Patronics/USBC-Tester/USBCTester/USBCTester.kicad_pcb

## KiCad design USBCTester/USBCTester.kicad_pcb (2024-05-14)

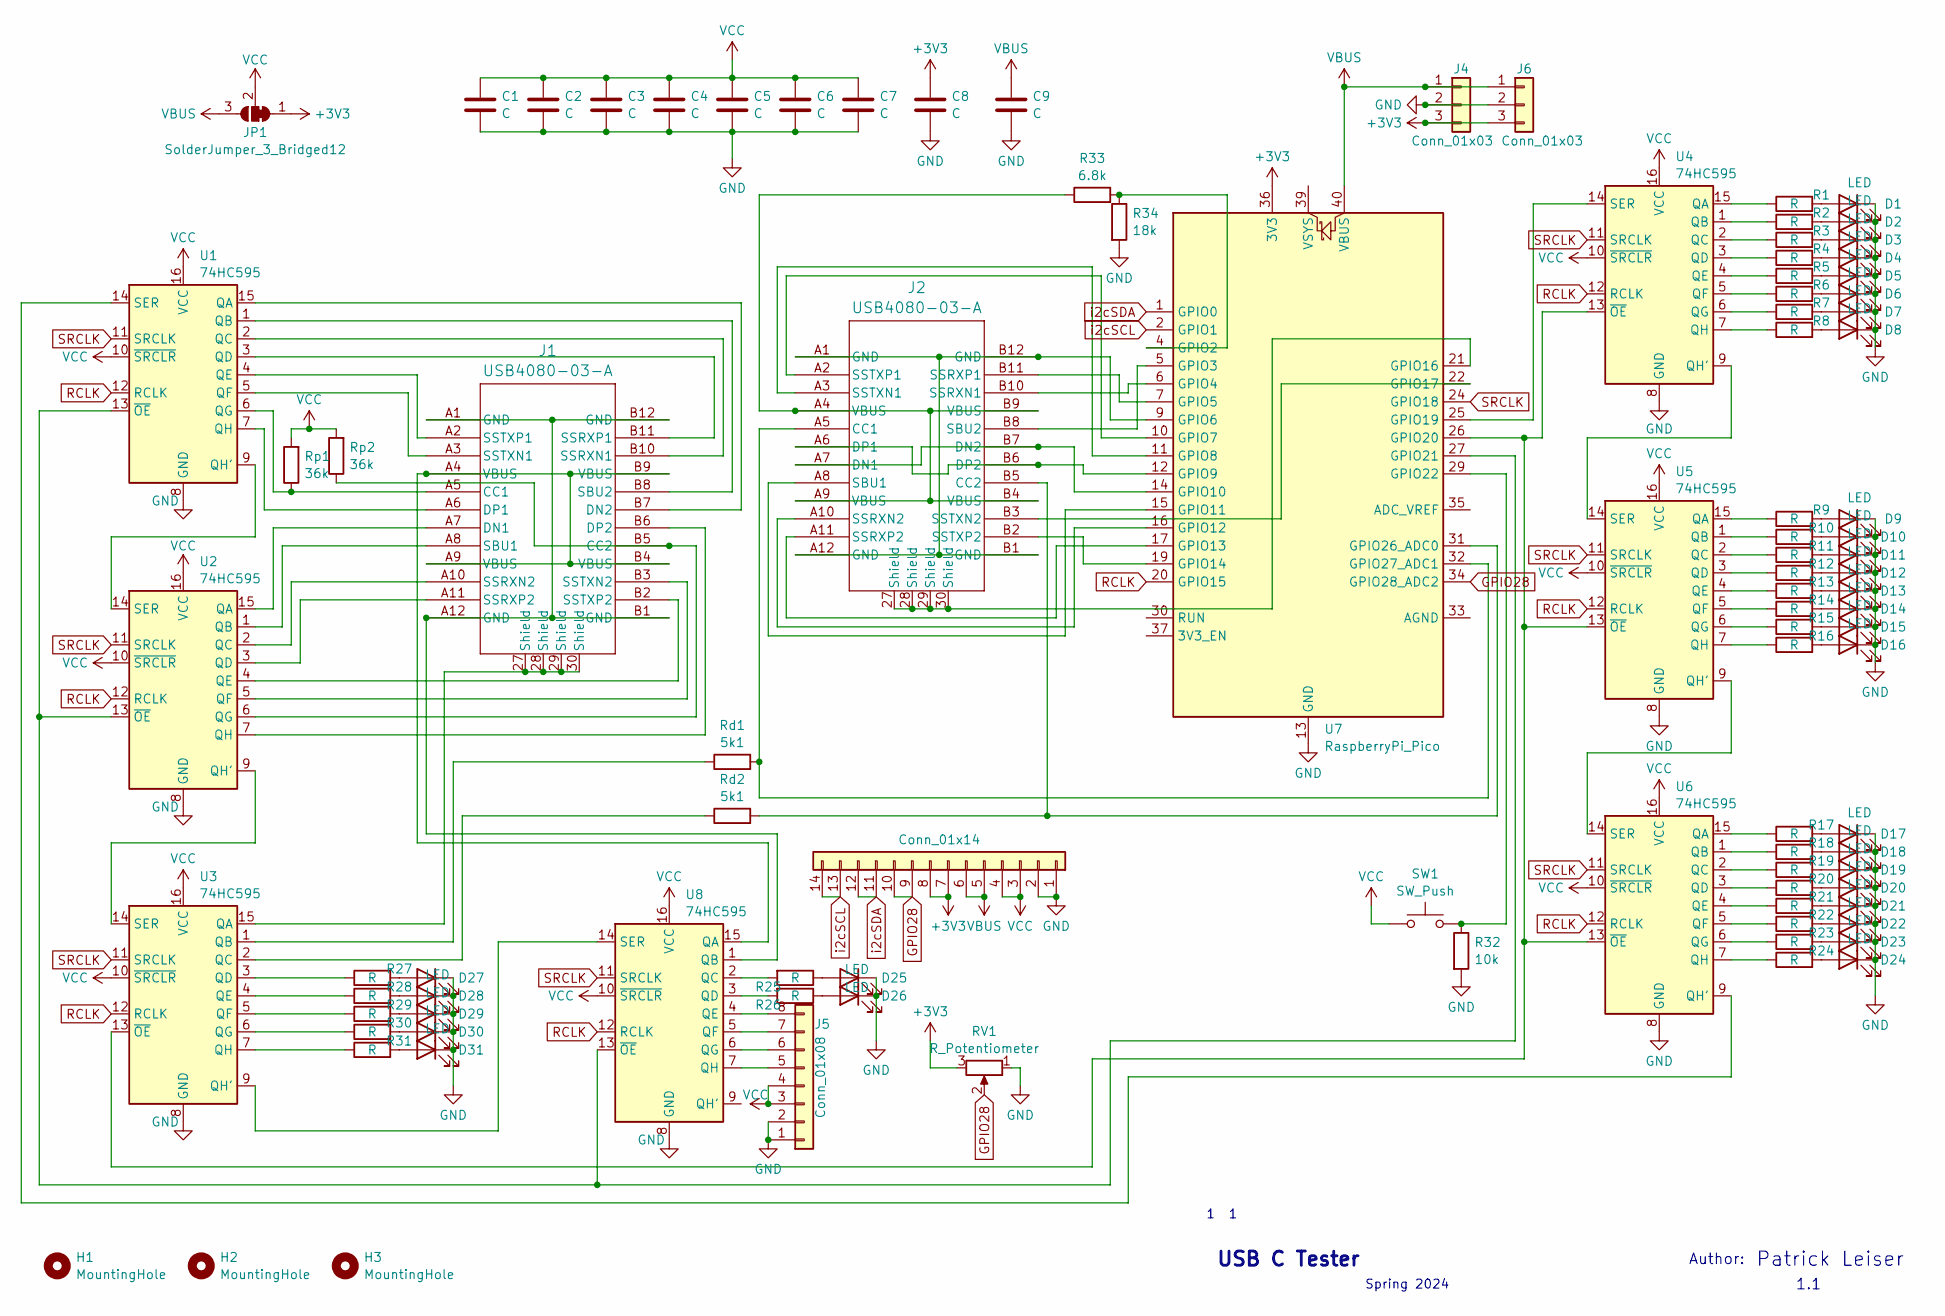
[picture p2: schematic USBCTester.kicad_sch]

Parts:
C1, C2, C3, C4, C5, C6, C7, C8, C9: C; C_0603_1608Metric
D1, D2, D3, D4, D5, D6, D7, D8, D9, D10, D11, D12, D13, D14, D15, D16, D17, D18, D19, D20, D21, D22, D23, D24, D25, D26, D27, D28, D29, D30, D31: LED; LED_0603_1608Metric
H1, H2, H3: MountingHole; MountingHole_3.2mm_M3
J1, J2: USB4080-03-A; USB4080-03-A_GCT_RoundHoles
J3: Conn_01x14; PinSocket_1x14_P2.54mm_Vertical
J4, J6: Conn_01x03; PinSocket_1x03_P2.54mm_Vertical
J5: Conn_01x08; PinHeader_2x04_P2.54mm_Vertical
JP1: SolderJumper_3_Bridged12; SolderJumper-3_P1.3mm_Bridged12_RoundedPad1.0x1.5mm
R1, R2, R3, R4, R5, R6, R7, R8, R9, R10, R11, R12, R13, R14, R15, R16, R17, R18, R19, R20, R21, R22, R23, R24, R25, R26, R27, R28, R29, R30, R31: R; R_0603_1608Metric
R32: 10k; R_0603_1608Metric
R33: 6.8k; R_0603_1608Metric
R34: 18k; R_0603_1608Metric
RV1: R_Potentiometer; TRIM_35WR10KLFTR
Rd1, Rd2: 5k1; R_0603_1608Metric
Rp1, Rp2: 36k; R_0603_1608Metric
SW1: SW_Push; SW_Push_1P1T_NO_6x6mm_H9.5mm
U1, U2, U3, U4, U5, U6, U8: 74HC595; SOIC-16_3.9x9.9mm_P1.27mm
U7: RaspberryPi_Pico; RaspberryPi_Pico_Common

Connections:
+3V3: C8.1, J3.7, J3.8, J4.3, J6.3, JP1.1 (A), RV1.3, U7.36 (3V3)
GND: C1.2, C2.2, C3.2, C4.2, C5.2, C6.2, C7.2, C8.2, C9.2, D1.1 (K), D2.1 (K), D3.1 (K), D4.1 (K), D5.1 (K), D6.1 (K), D7.1 (K), D8.1 (K), D9.1 (K), D10.1 (K), D11.1 (K), D12.1 (K), D13.1 (K), D14.1 (K), D15.1 (K), D16.1 (K), D17.1 (K), D18.1 (K), D19.1 (K), D20.1 (K), D21.1 (K), D22.1 (K), D23.1 (K), D24.1 (K), D25.1 (K), D26.1 (K), D27.1 (K), D28.1 (K), D29.1 (K), D30.1 (K), D31.1 (K), J3.1, J3.2, J4.2, J5.1, J5.2, J6.2, R32.2, R34.2, RV1.1, U1.8 (GND), U2.8 (GND), U3.8 (GND), U4.8 (GND), U5.8 (GND), U6.8 (GND), U7.3 (GND), U7.8 (GND), U7.13 (GND), U7.18 (GND), U7.23 (GND), U7.28 (GND), U7.38 (GND), U8.8 (GND)
GPIO28: J3.9, J3.10, RV1.2, U7.34 (GPIO28_ADC2)
unnamed: D1.2 (A), R1.2
unnamed: D2.2 (A), R2.2
unnamed: D3.2 (A), R3.2
unnamed: D4.2 (A), R4.2
unnamed: D5.2 (A), R5.2
unnamed: D6.2 (A), R6.2
unnamed: D7.2 (A), R7.2
unnamed: D8.2 (A), R8.2
unnamed: D9.2 (A), R9.2
unnamed: D10.2 (A), R10.2
unnamed: D11.2 (A), R11.2
unnamed: D12.2 (A), R12.2
unnamed: D13.2 (A), R13.2
unnamed: D14.2 (A), R14.2
unnamed: D15.2 (A), R15.2
unnamed: D16.2 (A), R16.2
unnamed: D17.2 (A), R17.2
unnamed: D18.2 (A), R18.2
unnamed: D19.2 (A), R19.2
unnamed: D20.2 (A), R20.2
unnamed: D21.2 (A), R21.2
unnamed: D22.2 (A), R22.2
unnamed: D23.2 (A), R23.2
unnamed: D24.2 (A), R24.2
unnamed: D25.2 (A), R25.1
unnamed: D26.2 (A), R26.1
unnamed: D27.2 (A), R27.2
unnamed: D28.2 (A), R28.2
unnamed: D29.2 (A), R29.2
unnamed: D30.2 (A), R30.2
unnamed: D31.2 (A), R31.2
unnamed: J1.A5 (CC1), Rp1.1, U1.6 (QG)
unnamed: J1.B5 (CC2), Rp2.1, U2.6 (QG)
unnamed: J1.A7 (DN1), U2.15 (QA)
unnamed: J1.B7 (DN2), U1.15 (QA)
unnamed: J1.A6 (DP1), U1.7 (QH)
unnamed: J1.B6 (DP2), U2.7 (QH)
unnamed: J1.A8 (SBU1), U2.1 (QB)
unnamed: J1.B8 (SBU2), U1.1 (QB)
unnamed: J1.B10 (SSRXN1), U1.2 (QC)
unnamed: J1.A10 (SSRXN2), U2.2 (QC)
unnamed: J1.B11 (SSRXP1), U1.3 (QD)
unnamed: J1.A11 (SSRXP2), U2.3 (QD)
unnamed: J1.A3 (SSTXN1), U1.5 (QF)
unnamed: J1.B3 (SSTXN2), U2.5 (QF)
unnamed: J1.A2 (SSTXP1), U1.4 (QE)
unnamed: J1.B2 (SSTXP2), U2.4 (QE)
unnamed: J2.A5 (CC1), Rd1.2, U7.32 (GPIO27_ADC1)
unnamed: J2.B5 (CC2), Rd2.2, U7.31 (GPIO26_ADC0)
unnamed: J2.A7 (DN1), J2.B7 (DN2), U7.14 (GPIO10)
unnamed: J2.A6 (DP1), J2.B6 (DP2), U7.12 (GPIO9)
unnamed: J2.A8 (SBU1), U7.15 (GPIO11)
unnamed: J2.B8 (SBU2), U7.5 (GPIO3)
unnamed: J2.B10 (SSRXN1), U7.6 (GPIO4)
unnamed: J2.A10 (SSRXN2), U7.16 (GPIO12)
unnamed: J2.B11 (SSRXP1), U7.7 (GPIO5)
unnamed: J2.A11 (SSRXP2), U7.17 (GPIO13)
unnamed: J2.A3 (SSTXN1), U7.11 (GPIO8)
unnamed: J2.B3 (SSTXN2), U7.22 (GPIO17)
unnamed: J2.A2 (SSTXP1), U7.10 (GPIO7)
unnamed: J2.B2 (SSTXP2), U7.19 (GPIO14)
unnamed: J2.A4 (VBUS), J2.A9 (VBUS), J2.B4 (VBUS), J2.B9 (VBUS), R33.1
unnamed: J5.5, U8.7 (QH)
unnamed: J5.6, U8.6 (QG)
unnamed: J5.7, U8.5 (QF)
unnamed: J5.8, U8.4 (QE)
unnamed: U1.9 (QH'), U2.14 (SER)
unnamed: U1.14 (SER), U6.9 (QH')
unnamed: U1.13 (~OE), U2.13 (~OE), U7.27 (GPIO21), U8.13 (~OE)
unnamed: U2.9 (QH'), U3.14 (SER)
unnamed: J1.27 (Shield), J1.28 (Shield), J1.29 (Shield), J1.30 (Shield), U3.15 (QA)
unnamed: Rd1.1, U3.1 (QB)
unnamed: Rd2.1, U3.2 (QC)
unnamed: R27.1, U3.3 (QD)
unnamed: R28.1, U3.4 (QE)
unnamed: R29.1, U3.5 (QF)
unnamed: R30.1, U3.6 (QG)
unnamed: U3.9 (QH'), U8.14 (SER)
unnamed: R31.1, U3.7 (QH)
unnamed: U3.13 (~OE), U4.13 (~OE), U5.13 (~OE), U6.13 (~OE), U7.26 (GPIO20)
unnamed: R1.1, U4.15 (QA)
unnamed: R2.1, U4.1 (QB)
unnamed: R3.1, U4.2 (QC)
unnamed: R4.1, U4.3 (QD)
unnamed: R5.1, U4.4 (QE)
unnamed: R6.1, U4.5 (QF)
unnamed: R7.1, U4.6 (QG)
unnamed: U4.9 (QH'), U5.14 (SER)
unnamed: R8.1, U4.7 (QH)
unnamed: U4.14 (SER), U7.25 (GPIO19)
unnamed: R9.1, U5.15 (QA)
unnamed: R10.1, U5.1 (QB)
unnamed: R11.1, U5.2 (QC)
unnamed: R12.1, U5.3 (QD)
unnamed: R13.1, U5.4 (QE)
unnamed: R14.1, U5.5 (QF)
unnamed: R15.1, U5.6 (QG)
unnamed: U5.9 (QH'), U6.14 (SER)
unnamed: R16.1, U5.7 (QH)
unnamed: R17.1, U6.15 (QA)
unnamed: R18.1, U6.1 (QB)
unnamed: R19.1, U6.2 (QC)
unnamed: R20.1, U6.3 (QD)
unnamed: R21.1, U6.4 (QE)
unnamed: R22.1, U6.5 (QF)
unnamed: R23.1, U6.6 (QG)
unnamed: R24.1, U6.7 (QH)
unnamed: R33.2, R34.1, U7.4 (GPIO2)
unnamed: J2.A1 (GND), J2.A12 (GND), J2.B1 (GND), J2.B12 (GND), U7.9 (GPIO6)
unnamed: J2.27 (Shield), J2.28 (Shield), J2.29 (Shield), J2.30 (Shield), U7.21 (GPIO16)
unnamed: R32.1, SW1.2, U7.29 (GPIO22)
unnamed: J1.A4 (VBUS), J1.A9 (VBUS), J1.B4 (VBUS), J1.B9 (VBUS), U8.15 (QA)
unnamed: J1.A1 (GND), J1.A12 (GND), J1.B1 (GND), J1.B12 (GND), U8.1 (QB)
unnamed: R25.2, U8.2 (QC)
unnamed: R26.2, U8.3 (QD)
RCLK: U1.12 (RCLK), U2.12 (RCLK), U3.12 (RCLK), U4.12 (RCLK), U5.12 (RCLK), U6.12 (RCLK), U7.20 (GPIO15), U8.12 (RCLK)
SRCLK: U1.11 (SRCLK), U2.11 (SRCLK), U3.11 (SRCLK), U4.11 (SRCLK), U5.11 (SRCLK), U6.11 (SRCLK), U7.24 (GPIO18), U8.11 (SRCLK)
VBUS: C9.1, J3.5, J3.6, J4.1, J6.1, JP1.3 (B), U7.40 (VBUS)
VCC: C1.1, C2.1, C3.1, C4.1, C5.1, C6.1, C7.1, J3.3, J3.4, J5.3, J5.4, JP1.2 (C), Rp1.2, Rp2.2, SW1.1, U1.10 (~SRCLR), U1.16 (VCC), U2.10 (~SRCLR), U2.16 (VCC), U3.10 (~SRCLR), U3.16 (VCC), U4.10 (~SRCLR), U4.16 (VCC), U5.10 (~SRCLR), U5.16 (VCC), U6.10 (~SRCLR), U6.16 (VCC), U8.10 (~SRCLR), U8.16 (VCC)
i2cSCL: J3.13, J3.14, U7.2 (GPIO1)
i2cSDA: J3.11, J3.12, U7.1 (GPIO0)

Notes on the sheet:
Author:
Spring 2024
Patrick Leiser
1.1
1 1
USB C Tester

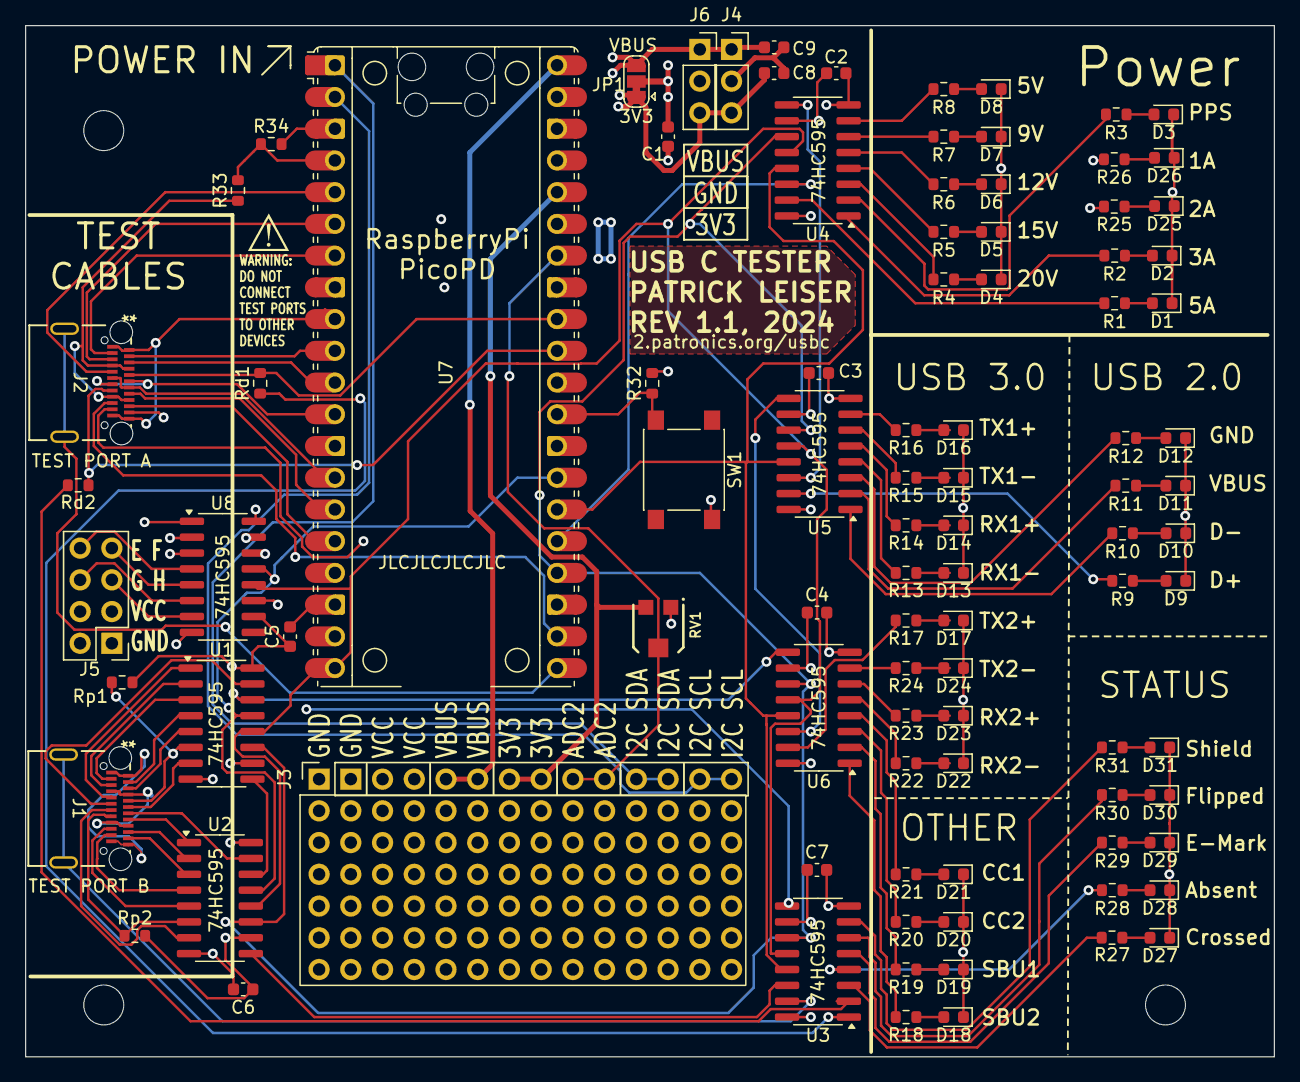
[picture p3: board USBCTester.kicad_pcb from above]

Board: 4 copper layers, 100.0 x 82.6 mm, 99 parts (0 on the bottom side), 124 nets.

Other parts of the board:
PB1: ProtoBoard 14x6
