Patronics/USBC-Tester/(commit log)

2024-02-11 initial commit, add kicad files so far
    [USBCTester.kicad_pcb, USBCTester.kicad_sch]
2024-02-11 add power plane and vias for high current and decoupling caps
    [USBCTester.kicad_pcb, USBCTester.kicad_sch]
2024-02-12 continu wiring and add decoupling caps
    [USBCTester.kicad_pcb, USBCTester.kicad_sch]
2024-02-12 add usb c port footprint and symbol
2024-02-12 organize usb2 and usb3 status leds
    [USBCTester.kicad_pcb]
2024-02-13 add more leds and route almost everything
    [USBCTester.kicad_pcb, USBCTester.kicad_sch]
2024-02-13 label all LEDs
    [USBCTester.kicad_pcb]
2024-02-13 add breakout pins for prototyping
    [USBCTester.kicad_pcb, USBCTester.kicad_sch]
2024-02-16 made board more compact
    [USBCTester.kicad_pcb]
2024-02-16 add 3rd incompatible footprint design
    [USBCTester.kicad_pcb, USBCTester.kicad_sch]
2024-02-16 switch to USB4080 footprint
    [USBCTester.kicad_pcb, USBCTester.kicad_sch]
2024-02-16 add protoboard, lots of tweaks and silkscreen improvements
    [USBCTester.kicad_pcb, USBCTester.kicad_sch]
2024-02-21 many tweaks to finalize design, then Schematic update for safety with external devices
    [USBCTester.kicad_pcb, USBCTester.kicad_sch]
2024-02-21 update layout with improved external device safety and testing for active cables
    [USBCTester.kicad_pcb, USBCTester.kicad_sch]
2024-02-26 pretty and useful back silkscreen
    [USBCTester.kicad_pcb]
2024-02-27 adjust layout to preseve i2c pins, and general layout cleanup
    [USBCTester.kicad_pcb, USBCTester.kicad_sch]
2024-02-27 minor cleanup and reorganization
    [USBCTester.kicad_pcb, USBCTester.kicad_sch]
2024-02-27 adjust text background style, last 7.0 commit
    [USBCTester.kicad_pcb]
2024-02-29 use older footprint for USBC since JLCPCB does seem to tolerate the shape, and minor silkscreen fixes
    [USBCTester.kicad_pcb, USBCTester.kicad_sch]
2024-03-04 simplify nested folders
    [USBCTester.kicad_pcb, USBCTester.kicad_sch]
2024-03-04 move pretty footprints
2024-03-10 initial commit of power tester, proof of concept drives shift registers
2024-03-10 make remapLeds function to set LED bitmap to cleaner order
2024-03-10 minor fix and optimization
    [powerTester.ino]
2024-03-10 successfully tests USB PD voltages
2024-03-10 animate progress in scanning supported voltages
2024-03-10 improve handling of tolerances, especially 5v tolerance
    [powerTester.ino]
2024-03-10 rename shiftOut to shiftOutBit to avoid overriding Arduino's native shiftOut function
    [powerTester.ino]
2024-03-11 add defines for all the pico's pins
2024-03-12 add software dimming of bright leds
2024-03-12 add ifdef to disable pwm dimming if not needed
2024-03-19 update kicad files with JLC BOM and to fix silkscreen issue in V1
    [USBCTester.kicad_pcb, USBCTester.kicad_sch]
2024-03-19 add errata description of individual boards
    [powerTester.ino]
2024-03-19 add #defines for each physical board made so far for hardware-specific tweaks as needed
2024-03-24 add comment noting idea for scanning brightness of power LEDs to indicate current level per supported voltage
2024-03-30 WIP improve handling of shield (internally tied to ground), and start on testing other pins badly
2024-04-25 revision 1.2, add another shift register and fix the production files
    [USBCTester.kicad_pcb, USBCTester.kicad_sch, mapping.csv]
2024-04-25 add resistors to db
2024-04-30 update errata to handle board rev 1.1. Final version of code optimized for v1.0 boards
    [powerTester.ino]
2024-04-30 semi-untested modifications for rev1.1 boards
2024-04-30 fixed infinite loop due to inadequate type sizes
    [powerTester.ino]
2024-05-03 successfully tests USB2 data+ pin
2024-05-03 fix handling of USB3 pins
    [powerTester.ino]
2024-05-03 Fix power pins, shield, and re-add absent indicator
    [powerTester.ino]
2024-05-09 slow down sampling in order to make kendrick's cable vbus work
2024-05-14 update PCB and Schematic files
    [USBCTester.kicad_pcb, USBCTester.kicad_sch]
2024-05-15 fix background in exported powerpoint file
2024-05-15 update PDF format and remove badly formatted powerpoint file
